Meluhlah/ESC_Board/Resources/REV01-ESC_Board_REV01 - Schematics.pdf

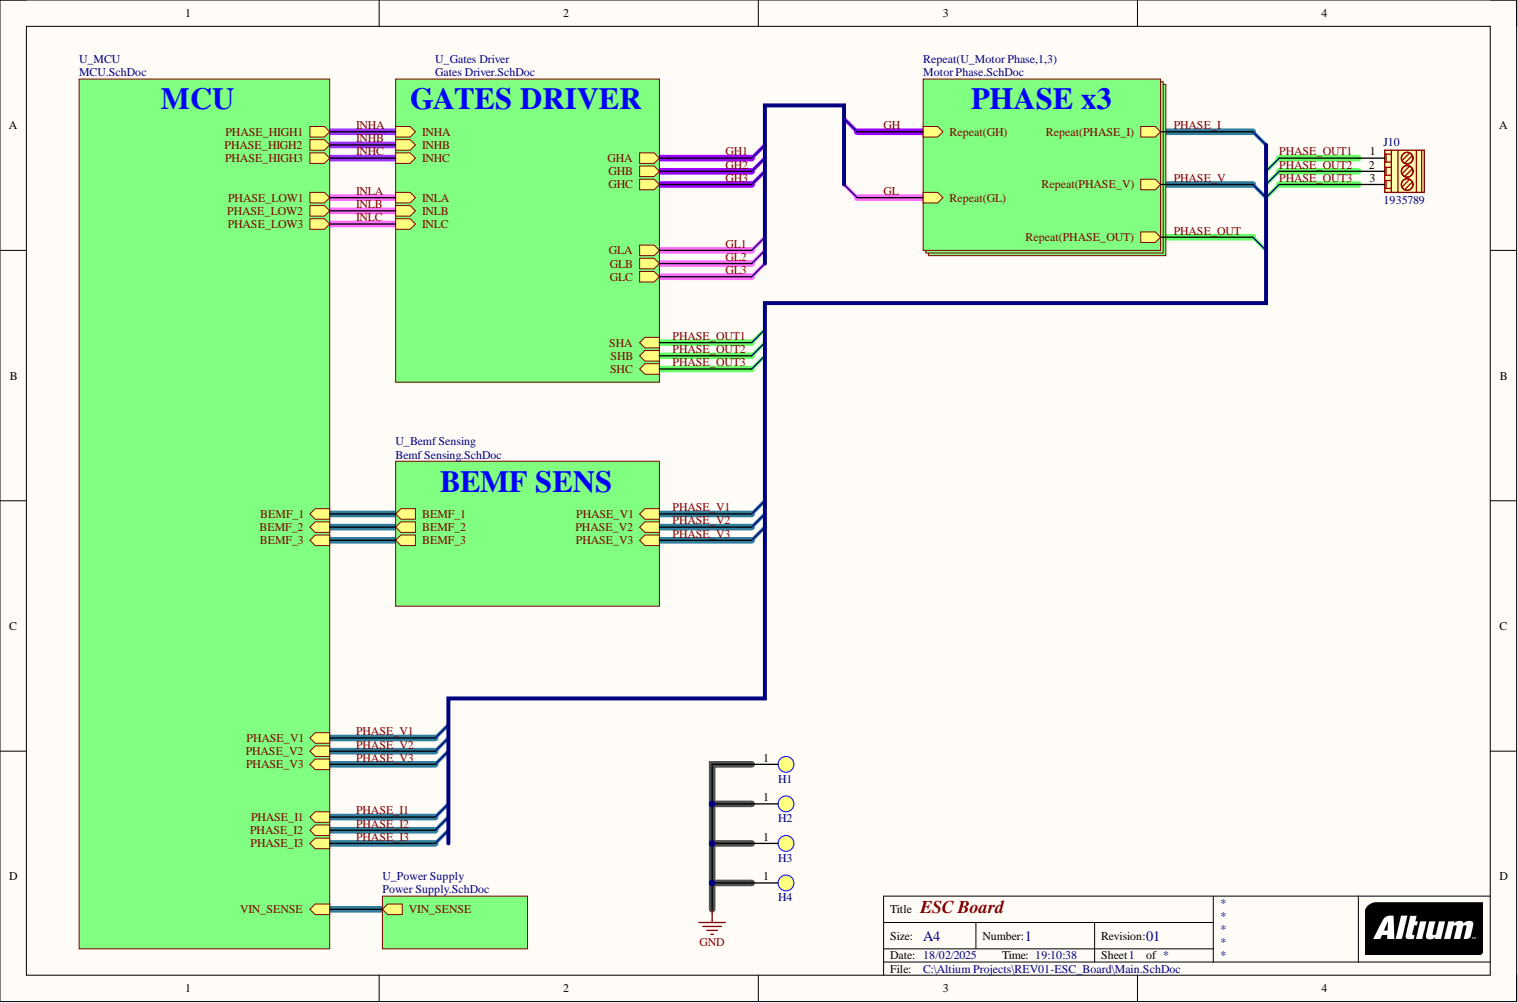
[picture p1: page 1]

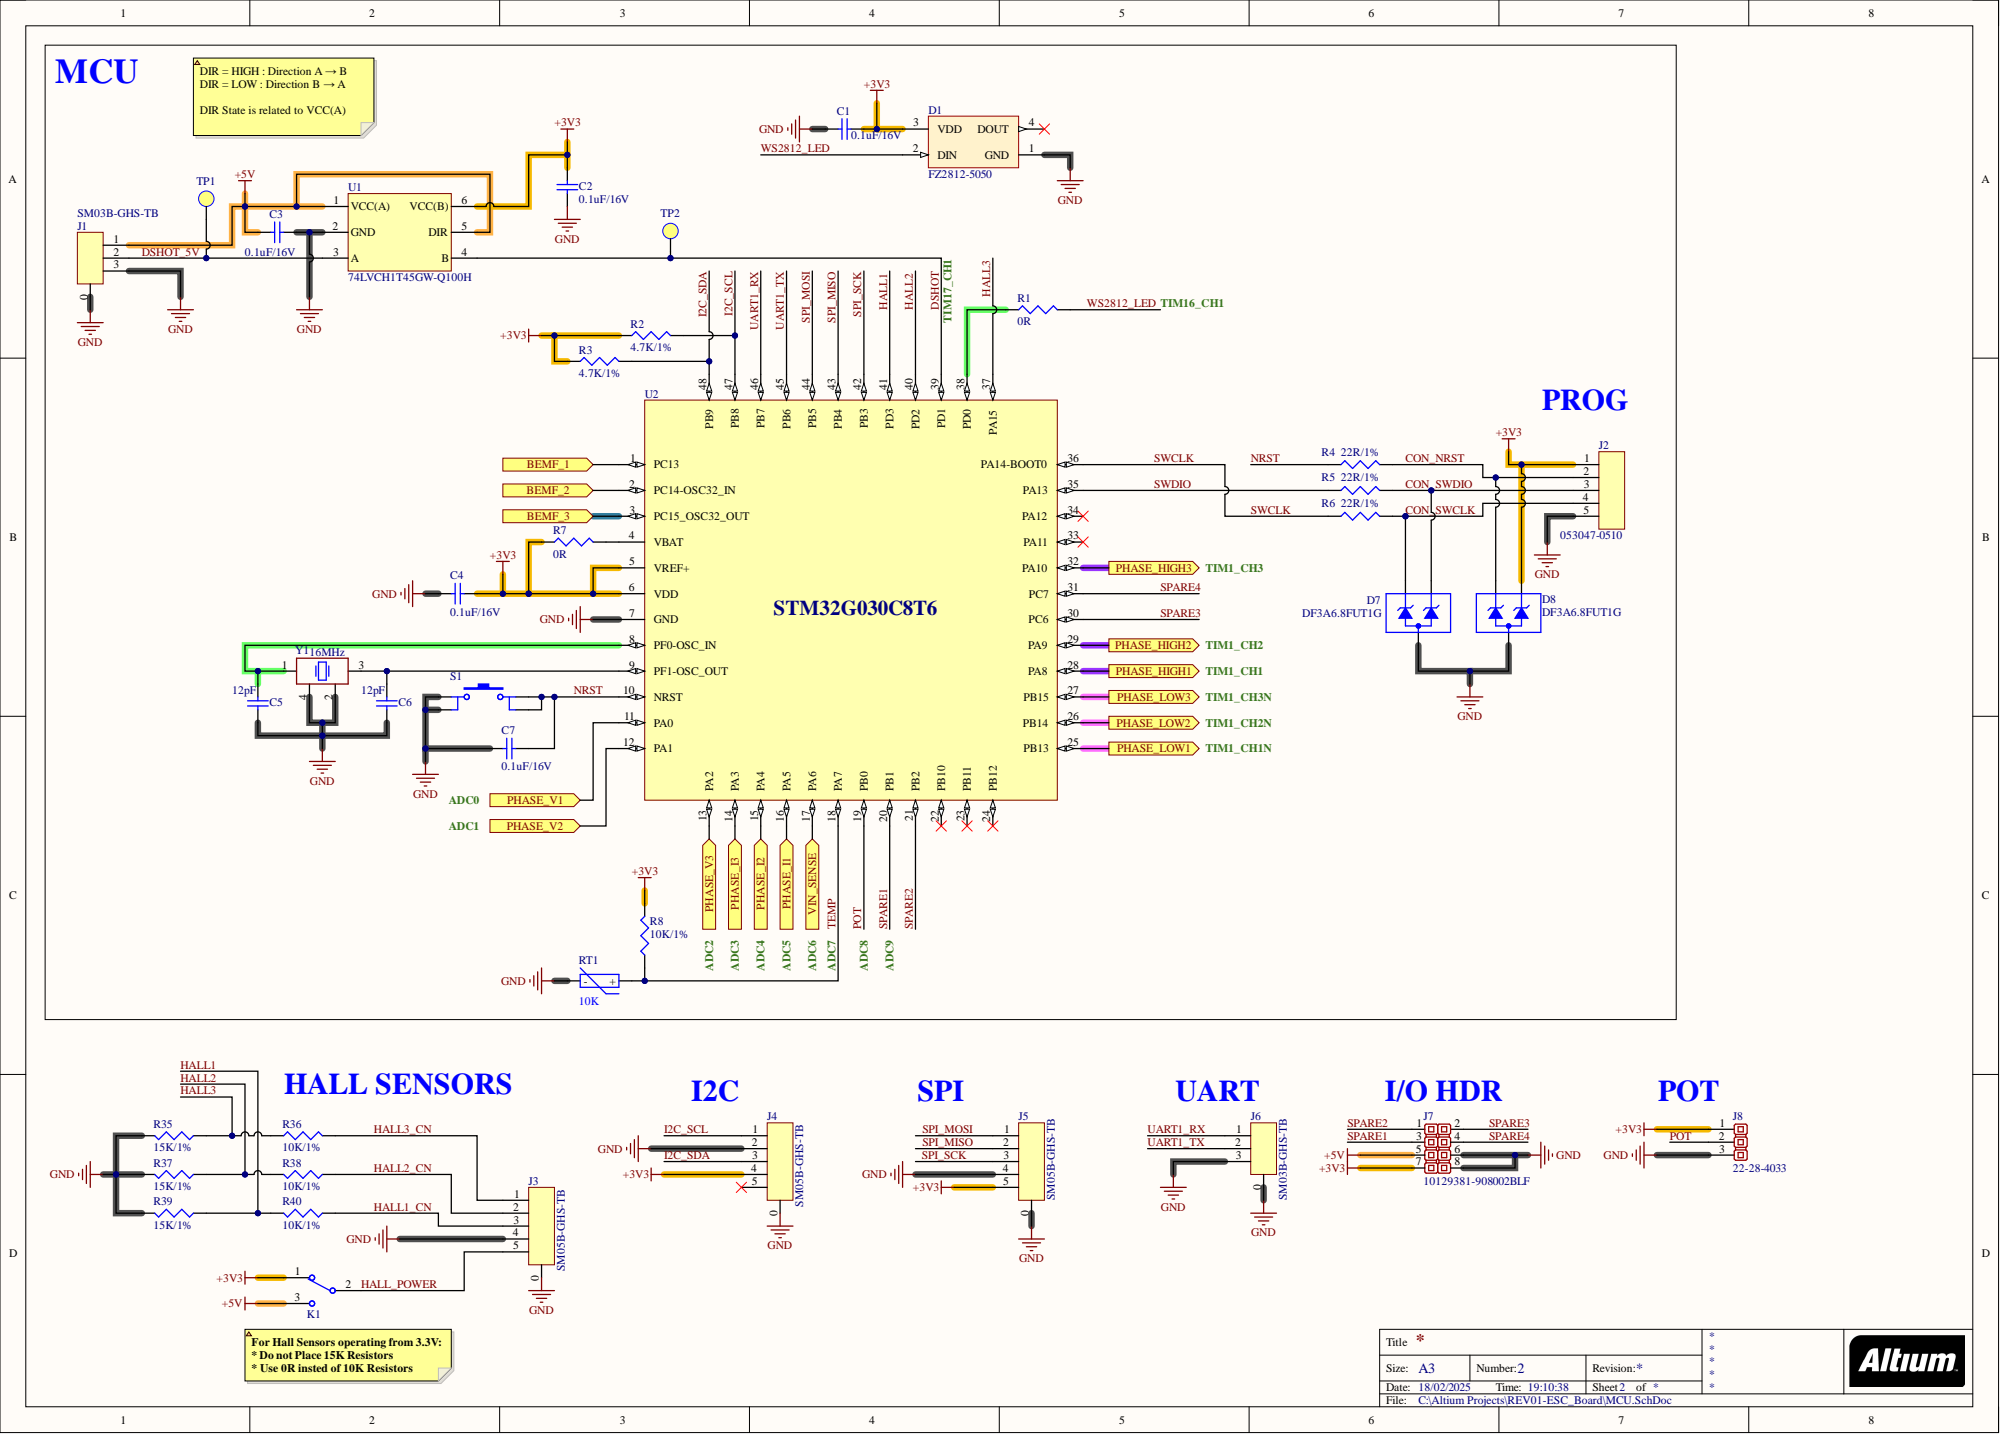
[picture p2: page 2]

DIR State is related to VCC(A)

GND 2

S1 NRST | NRST 10

HALL1_CN | 2

For Hall Sensors operating from 3.3V:
* Do not Place 15K Resistors
* Use 0R insted of 10K Resistors

C:\Altium Projects\REV01-ESC_Board\MCU.SchDoc

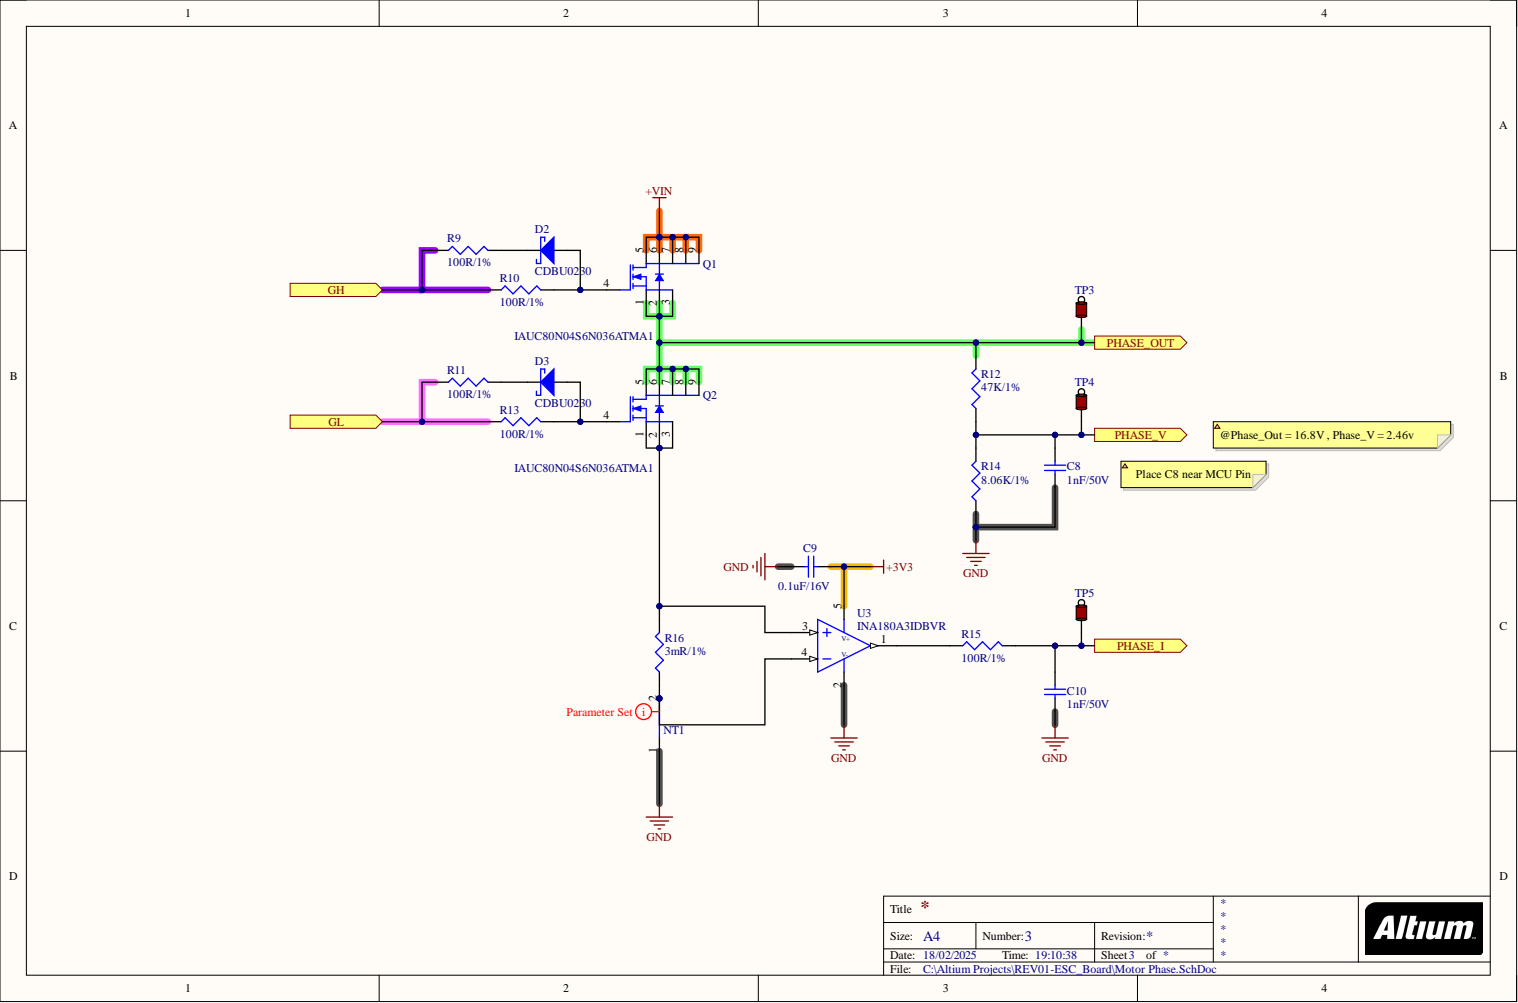
[picture p3: page 3]

Place C8 near MCU Pin

C:\Altium Projects\REV01-ESC_Board\Motor Phase.SchDoc

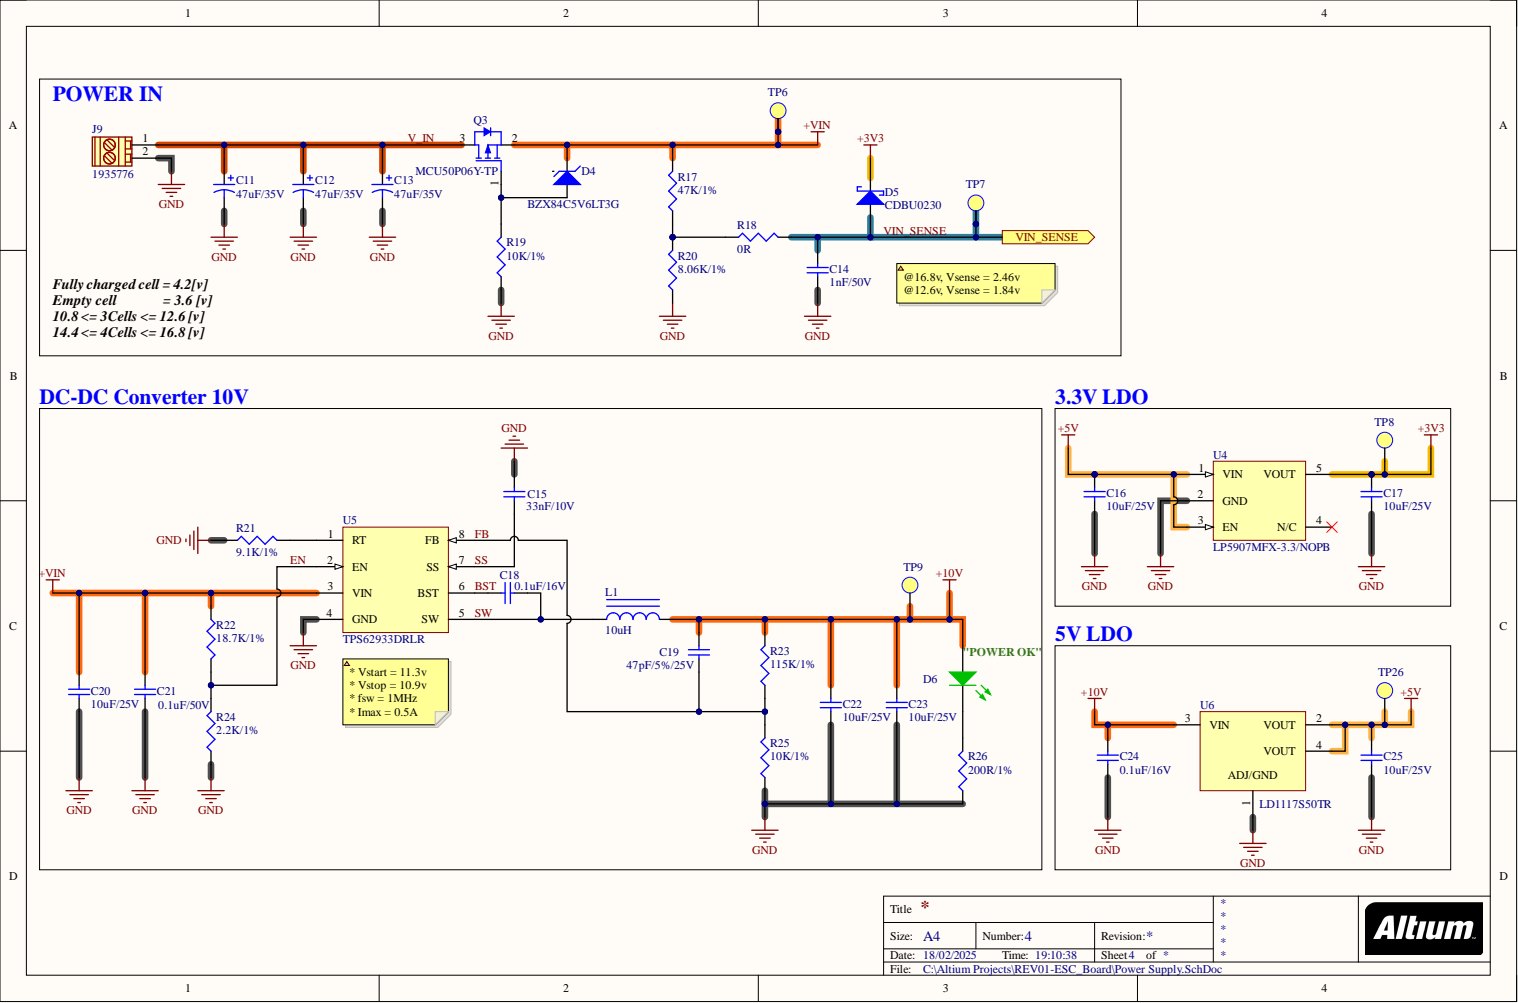
[picture p4: page 4]

C:\Altium Projects\REV01-ESC_Board\Power Supply.SchDoc

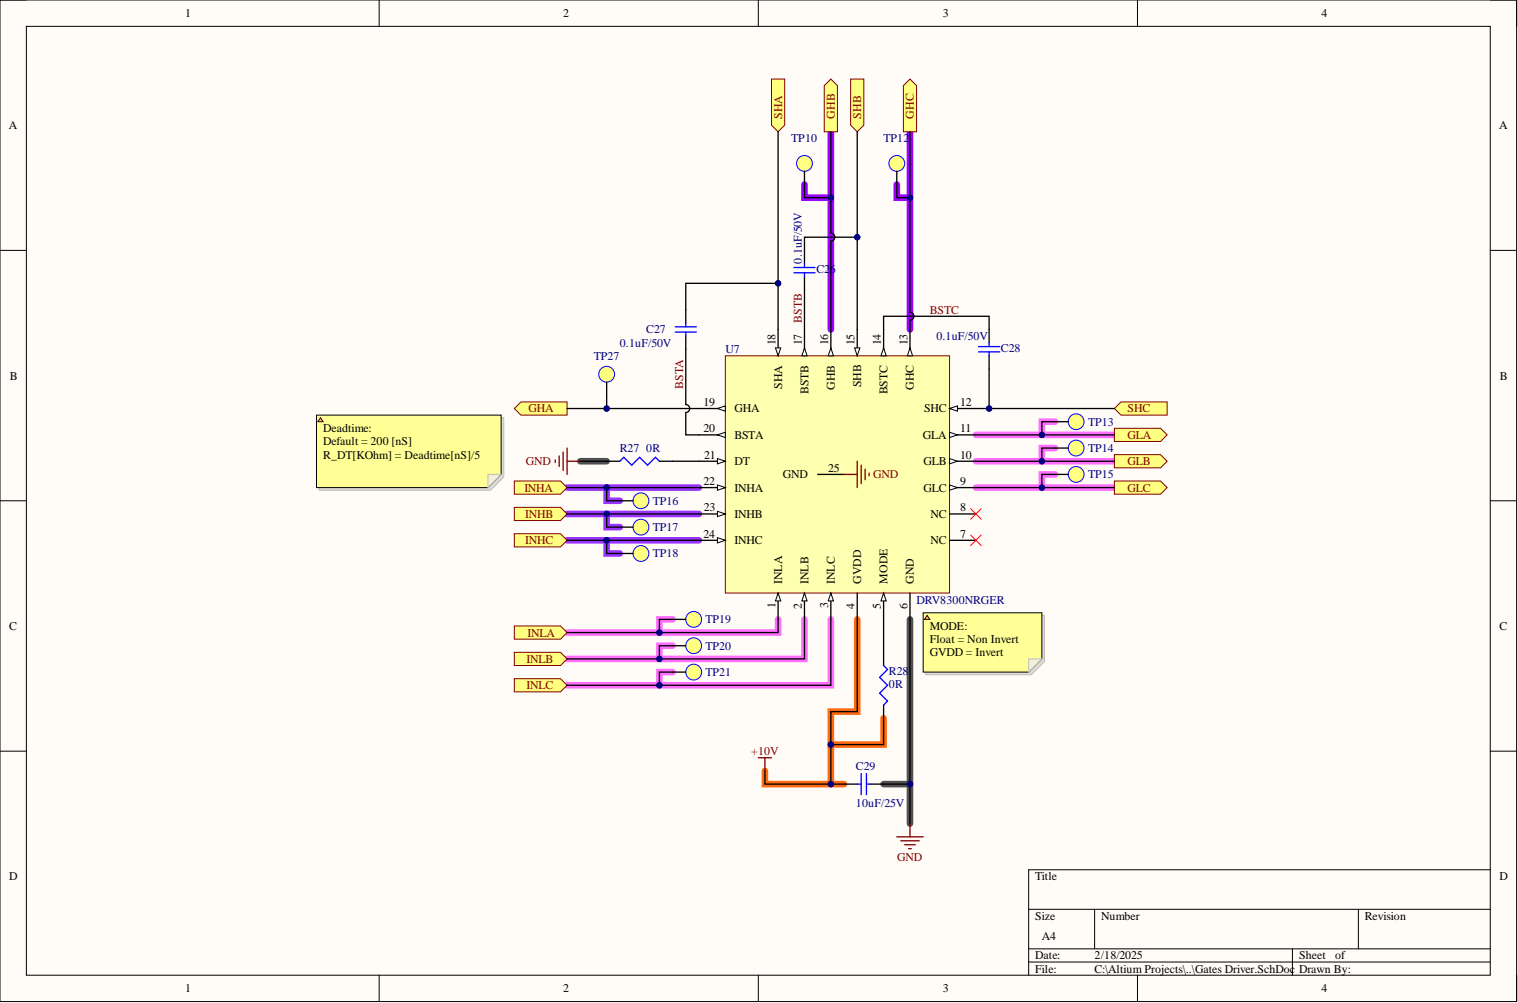
[picture p5: page 5]

INHC 24

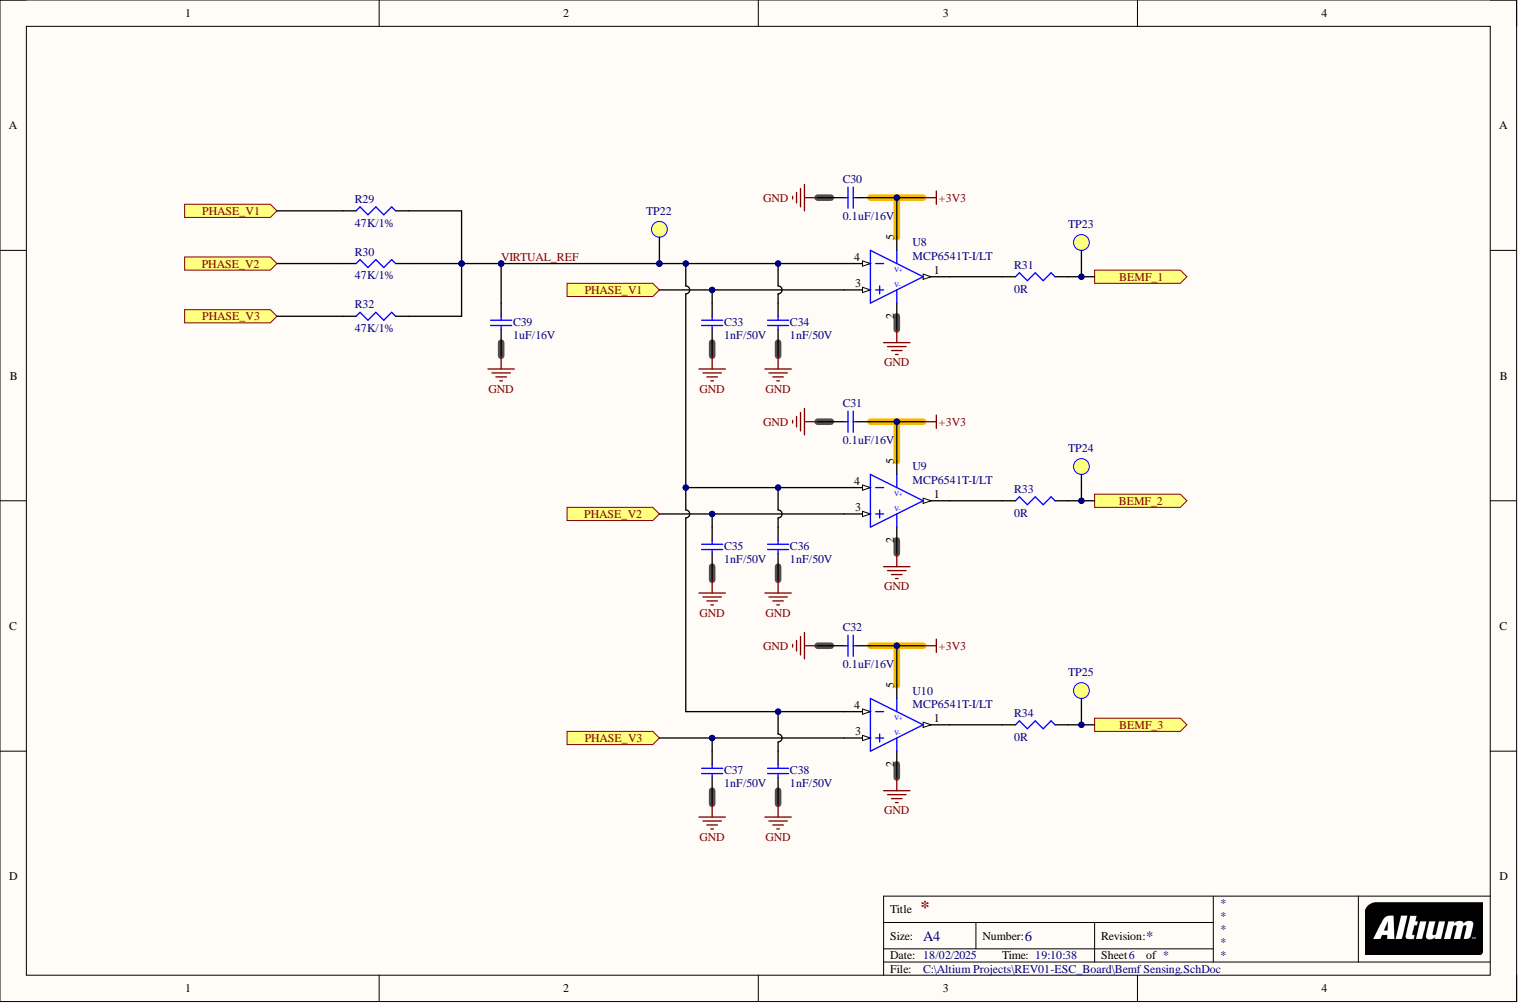
[picture p6: page 6]

C:\Altium Projects\REV01-ESC_Board\Bemf Sensing.SchDoc
