Meluhlah/ESC_Board/Cpp/Src/maincpp.cpp

#include "maincpp.h"


// ******************** Global Variables ******************** //

// Commutation Params *************************************** //

Phase phaseA(&htim1, TIM_CHANNEL_1, &TIM1->CCR1, PHASE1_LOW_GPIO_Port, PHASE1_LOW_Pin);
Phase phaseB(&htim1, TIM_CHANNEL_2, &TIM1->CCR2, PHASE2_LOW_GPIO_Port, PHASE2_LOW_Pin);
Phase phaseC(&htim1, TIM_CHANNEL_3, &TIM1->CCR3, PHASE3_LOW_GPIO_Port, PHASE3_LOW_Pin);

volatile uint8_t commutation_step;
volatile uint8_t zc_counter = 0;
volatile uint32_t imrDefaultFlags = 0;
uint8_t zcDetEnable = 0;

// ADC ****************************************************** //

volatile uint16_t adcBuffer[ADC_CHANNELS];

// Status Params ******************************************** //
volatile MotorState_e motorState;
volatile Error_e error;

// Delay Params ********************************************* //
volatile uint8_t tim14DelayFlag = 0;

// WS2812B LED Params *************************************** //
led_t ws2812b_led[NUM_OF_LEDS];

// Communication ******************************************** //
UartPacketTx_t uartPacketTx = {0x01, 0x00, 0x0000, 0x00, 0x00, DIRECTION_ABC, MOTOR_STATE_IDLE, NO_ERROR, 0x00, {0x00, 0x00, 0x00}, {0x00, 0x00, 0x00},0x00};
UartPacketRx_t uartPacketRx = {0x01, CMD_IDLE, 0x00, {0x00, 0x00, 0x00}, 0x00};
volatile uint8_t uartTxFlag = 0;
volatile uint8_t uartRxFlag = 0;
uint8_t uartRxBuffer[sizeof(UartPacketRx_t)];

// PID ****************************************************** //
PidController_t pid;
uint32_t rpmSpeed = 0;


// Debugger ************************************************* //
#ifdef DEBUGGING
Debug DEBUGGER(&huart1);
#endif

// ********************************************************** //

void phasesOff(){

    phaseA.off();
    phaseB.off();
    phaseC.off();
    zcDetEnable = 0;
    motorState = MOTOR_STATE_IDLE;

}


void setPhasesPwm(uint32_t dutyCycle){

    phaseA.set_pwm(dutyCycle);
    phaseB.set_pwm(dutyCycle);
    phaseC.set_pwm(dutyCycle);

}


void delayMicro(uint16_t delay){
	__HAL_TIM_SET_COUNTER(&DELAY_TIMER, 0);
	while(__HAL_TIM_GET_COUNTER(&DELAY_TIMER) < delay);
}


void setup()
{   
    #ifdef DEBUGGING
    HAL_Delay(2);
    ws2812b_setColor(ws2812b_led, 0, 0, 255, 0);
    DEBUGGER << "Setup Function Called.\n";
    #endif
    
    ws2812b_init(ws2812b_led);
    
    EXTI->IMR1 &= ~(BEMF_1_Pin | BEMF_2_Pin | BEMF_3_Pin);
    imrDefaultFlags = EXTI->IMR1;
    
    phasesOff();
    setPhasesPwm(0);
    commutation_step = 0;
    error = NO_ERROR;
    motorState = MOTOR_STATE_IDLE;

    HAL_UARTEx_ReceiveToIdle_DMA(&huart1, uartRxBuffer, sizeof(UartPacketRx_t));
    HAL_ADC_Start_DMA(&hadc1, (uint32_t*)adcBuffer, sizeof(adcBuffer));
    HAL_TIM_Base_Start(&htim14);
    HAL_TIM_Base_Start(&htim17);
    HAL_TIM_Base_Start_IT(&htim3);

}


void commutate()
{

    EXTI->IMR1 = imrDefaultFlags;
    EXTI->IMR1 &= ~(BEMF_1_Pin | BEMF_2_Pin | BEMF_3_Pin);

    // Disabling Interrupts on BEMF inputs
    EXTI->RTSR1 &= ~(BEMF_1_Pin | BEMF_2_Pin | BEMF_3_Pin);
    EXTI->FTSR1 &= ~(BEMF_1_Pin | BEMF_2_Pin | BEMF_3_Pin);

    // Clearing Pending Interrupt Requests
    EXTI->RPR1 |= (BEMF_1_Pin | BEMF_2_Pin | BEMF_3_Pin);
    EXTI->FPR1 |= (BEMF_1_Pin | BEMF_2_Pin | BEMF_3_Pin);

    commutation_step++;
    commutation_step %= 6;

    uint32_t timerValue = 0;

    delayMicro(2);


    /*
        STEP:   0   1   2   3   4   5 | 0   1
                                      |
        HIGH:   A   B   B   C   C   A | A   B
                                      |
        OFF:    B   A   C   B   A   C | B   A
                                      |
        LOW:    C   C   A   A   B   B | C   C
                                      |
        BEMF:   ↑   ↓   ↑   ↓   ↑   ↓ | ↑   ↓
                B   A   C   B   A   C | B   A
    */

    switch(commutation_step)
    {
        case 0:

            timerValue = __HAL_TIM_GET_COUNTER(&RPM_TIMER);
            __HAL_TIM_SET_COUNTER(&RPM_TIMER, 0);
            if(timerValue != 0){
                rpmSpeed = ((60 * 1000000) / (timerValue * MOTOR_PARAM_POLE_PAIRS));
            }
            else{
                rpmSpeed = 0;
            }

            if(1 == zcDetEnable){
                EXTI->IMR1  = (imrDefaultFlags | BEMF_2_Pin);
                EXTI->RTSR1 |= BEMF_2_Pin;  // Enabling Rising Interrupt on B
            }

            phaseB.off();    
            phaseA.high_on();
            phaseC.low_on();
        break;

        case 1:
            if(1 == zcDetEnable){
                EXTI->IMR1  = (imrDefaultFlags | BEMF_1_Pin);
                EXTI->FTSR1 |= BEMF_1_Pin; // Enabling Falling Interrupt on A
            }
            phaseA.off();    
            phaseB.high_on();
            phaseC.low_on();
        break;
        
        case 2:
            if(1 == zcDetEnable){
                EXTI->IMR1  = (imrDefaultFlags | BEMF_3_Pin);
                EXTI->RTSR1 |= BEMF_3_Pin; // Enabling Rising Interrupt on C
            }
            phaseC.off();    
            phaseB.high_on();
            phaseA.low_on();
        break;
        
        case 3:
            if(1 == zcDetEnable){
                EXTI->IMR1  = (imrDefaultFlags | BEMF_2_Pin);
                EXTI->FTSR1 |= BEMF_2_Pin; // Enabling Falling Interrupt on B
            }
            phaseB.off();    
            phaseC.high_on();
            phaseA.low_on();
        break;
        
        case 4:
            if(1 == zcDetEnable){
                EXTI->IMR1  = (imrDefaultFlags | BEMF_1_Pin);
                EXTI->RTSR1 |= BEMF_1_Pin; // Enabling Rising Interrupt on A
            }
            phaseA.off();    
            phaseC.high_on();
            phaseB.low_on();
        break;
        
        case 5:
            if(1 == zcDetEnable){
                EXTI->IMR1  = (imrDefaultFlags | BEMF_3_Pin);
                EXTI->FTSR1 |= BEMF_3_Pin; // Enabling Falling Interrupt on C
            }

            phaseC.off();    
            phaseA.high_on();
            phaseB.low_on();
        break;
        
        default:
        break;


    }

    
}

// Used to filter False readings on interrupt pin
uint8_t getBemfStateRising(){
    
    if(commutation_step == 0){
        return (HAL_GPIO_ReadPin(BEMF_2_GPIO_Port, BEMF_2_Pin));
    }

    else if(commutation_step == 2){
        return (HAL_GPIO_ReadPin(BEMF_3_GPIO_Port, BEMF_3_Pin));
    }

    else if(commutation_step == 4){
        return (HAL_GPIO_ReadPin(BEMF_1_GPIO_Port, BEMF_1_Pin));
    }

    else
        return 0;


}

// Used to filter False readings on interrupt pin
uint8_t getBemfStateFalling(){
    
    if(commutation_step == 1){
        return (HAL_GPIO_ReadPin(BEMF_1_GPIO_Port, BEMF_1_Pin));
    }

    else if(commutation_step == 3){
        return (HAL_GPIO_ReadPin(BEMF_2_GPIO_Port, BEMF_2_Pin));
    }

    else if(commutation_step == 5){
        return (HAL_GPIO_ReadPin(BEMF_3_GPIO_Port, BEMF_3_Pin));
    }
    
    else
        return 0;

}

// TODO: Maybe Remove
void HAL_UART_TxCpltCallback(UART_HandleTypeDef *huart){

    if(huart->Instance == USART1){

        #ifdef DEBUGGER
        DEBUGGER.setTxFlag();
        #endif
    }

}


void HAL_UARTEx_RxEventCallback(UART_HandleTypeDef *huart, uint16_t Size){

    if(huart->Instance == USART1){
        if(sizeof(UartPacketRx_t) == Size){
            uartRxFlag = 1;
            memcpy(&uartPacketRx, uartRxBuffer, sizeof(UartPacketRx_t));
            HAL_UARTEx_ReceiveToIdle_DMA(huart, uartRxBuffer, sizeof(UartPacketRx_t));
    }

    }

}


void HAL_TIM_PeriodElapsedCallback(TIM_HandleTypeDef *htim){

    if(htim->Instance == TIM3){
        
        makeTxPacket(&uartPacketTx);
        HAL_UART_Transmit_DMA(&huart1, (uint8_t*)&uartPacketTx, sizeof(UartPacketTx_t));

    }

}


void HAL_TIM_PWM_PulseFinishedCallback(TIM_HandleTypeDef *htim){

    // WS2812B LED
    if(htim == &TIM_HANDLE){
		HAL_TIM_PWM_Stop_DMA(&TIM_HANDLE, TIM_CHANNEL);
	}   
}


void HAL_ADC_ConvCpltCallback(ADC_HandleTypeDef *hadc){

    HAL_ADC_Start_DMA(&hadc1, (uint32_t*)adcBuffer, sizeof(adcBuffer));

}


void HAL_GPIO_EXTI_Rising_Callback(uint16_t GPIO_Pin){

    if(GPIO_Pin == BEMF_1_Pin || GPIO_Pin == BEMF_2_Pin || GPIO_Pin == BEMF_3_Pin){

        #ifdef DEBUGGING
        HAL_GPIO_TogglePin(SPARE3_GPIO_Port, SPARE3_Pin);
        #endif

        if(zcDetEnable){
            zc_counter++;
        }
        
        if(motorState == MOTOR_STATE_AUTO_COMMUTATION){  
            
            delayMicro(TEST_ZC_MEASUREMENT_DELAY);
            if(getBemfStateRising() == 0){
                return;
            }         
            commutate();     

        }
    }
    
}


void HAL_GPIO_EXTI_Falling_Callback(uint16_t GPIO_Pin){

    if(GPIO_Pin == BEMF_1_Pin || GPIO_Pin == BEMF_2_Pin || GPIO_Pin == BEMF_3_Pin){

       #ifdef DEBUGGING
       HAL_GPIO_TogglePin(SPARE3_GPIO_Port, SPARE3_Pin);
       #endif


        if(zcDetEnable){
            zc_counter++;
        }
        
        if(motorState == MOTOR_STATE_AUTO_COMMUTATION){       
        
            delayMicro(TEST_ZC_MEASUREMENT_DELAY);
            if(getBemfStateFalling() == 1){
                return;
            }         
        
            commutate();          
        }
    }
}


void calc_checkSum(UartPacketTx_t* uartPacket_tx){
    uint32_t checksum = 0;
    checksum ^= uartPacket_tx->slaveId;
    checksum ^= uartPacket_tx->dutyCycle;
    checksum ^= uartPacket_tx->rpmValue;
    checksum ^= uartPacket_tx->temp;
    checksum ^= uartPacket_tx->vin;
    checksum ^= uartPacket_tx->direction;
    checksum ^= uartPacket_tx->state;
    checksum ^= uartPacket_tx->error;
    checksum ^= uartPacket_tx->flashParameterVal;
    checksum ^= uartPacket_tx->led_rgb.red;
    checksum ^= uartPacket_tx->led_rgb.green;
    checksum ^= uartPacket_tx->led_rgb.blue;
    checksum ^= uartPacket_tx->hallSensors[0];
    checksum ^= uartPacket_tx->hallSensors[1];
    checksum ^= uartPacket_tx->hallSensors[2];

    uartPacket_tx->checksum = checksum;

}


void makeTxPacket(UartPacketTx_t* uartPacket_tx){

    uartPacket_tx->direction            = DIRECTION_ABC;                    // TODO: Add support in code
    uartPacket_tx->dutyCycle            = (uint8_t)phaseA.get_duty_cycle();
    uartPacket_tx->rpmValue             = rpmSpeed;
    uartPacket_tx->error                = error;
    uartPacket_tx->slaveId              = 0x01;                             // TODO: Add support in code
    uartPacket_tx->led_rgb.red          = ws2812b_led->red;
    uartPacket_tx->led_rgb.green        = ws2812b_led->green;
    uartPacket_tx->led_rgb.blue         = ws2812b_led->blue;
    uartPacket_tx->state                = motorState;
    uartPacket_tx->temp                 = 0x00;                             // TODO: Add support in code
    uartPacket_tx->vin                  = 0x00;                             // TODO: Add support in code
    uartPacket_tx->hallSensors[0]       = 0x00;                             // TODO: Add support in code
    uartPacket_tx->hallSensors[1]       = 0x00;                             // TODO: Add support in code
    uartPacket_tx->hallSensors[2]       = 0x00;                             // TODO: Add support in code
    uartPacket_tx->flashParameterVal    = 0x0000;                           // TODO: Add support in code
    calc_checkSum(uartPacket_tx);
    
}


void motorAlign(){

    //TODO: Make Align function Smoother, Less Amp

    #ifdef DEBUGGING
    DEBUGGER << "Motor Align Function Called.\n";
    ws2812b_setGreen(ws2812b_led, 255);
    #endif
    
    motorState = MOTOR_STATE_ALIGN;
    setPhasesPwm(ALIGN_PWM_INIT);
    phaseB.low_on();
    phaseC.low_on();
    phaseA.high_on();

    float currentPwm = ALIGN_PWM_INIT;

    for(int i = 0; i < ALIGN_STEPS_NUM; i++){
        currentPwm += ALIGN_PWM_INCREMENT_PER_STEP;

        if(currentPwm <= ALIGN_PWM_TARGET){
            phaseA.set_pwm((uint32_t)currentPwm);
        }        

        HAL_Delay(ALIGN_STEP_DURATION_MS);
    }

    commutation_step = 0;

    #ifdef DEBUGGING
    DEBUGGER << "Motor Align Function Done.\n";
    #endif
}


void motorRamp(){

    #ifdef DEBUGGING
    DEBUGGER << "Motor Ramp Function Called.\n";
    ws2812b_setBlue(ws2812b_led, 255);
    #endif
    
    zcDetEnable = 0;
    zc_counter = 0;
    motorState = MOTOR_STATE_RAMP;
    setPhasesPwm(ALIGN_PWM_TARGET);
    uint16_t stepDelayUs = RAMP_STEP_INIT_DURATION_US;

    for(int i = 0; i < RAMP_STEPS_NUM; i++){

        if(zc_counter >= RAMP_ZC_DETECTION_THRESHOLD){

            motorState = MOTOR_STATE_AUTO_COMMUTATION;
            break;

        }

        if(i == RAMP_ZC_DET_ENABLE_STEP){

            zcDetEnable = 1;

        }
        commutate();

        if(stepDelayUs - RAMP_STEP_DECREMENT_PER_STEP_US >= RAMP_STEP_TARGET_DURATION_US){
           stepDelayUs -= RAMP_STEP_DECREMENT_PER_STEP_US;
        }
        delayMicro(stepDelayUs);
    }
    
    // Check for motor Lock.
    if(motorState != MOTOR_STATE_AUTO_COMMUTATION){
        error = ERROR_MOTOR_LOCKED;
        phasesOff();

    }

    #ifdef DEBUGGING
    DEBUGGER << "Motor Ramp Function Done.\n";
    #endif

}


void execGuiCommands(){

    switch(uartPacketRx.command){
        case CMD_MOTOR_STOP:
            phasesOff();
            break;

        case CMD_MOTOR_START:
            motorAlign();
            motorRamp();
            break;

        case CMD_MOTOR_ALIGN:
            motorAlign();
            phasesOff();
            break;

        case CMD_LED_SET_RED:
            ws2812b_setRed(ws2812b_led, uartPacketRx.data[0]);
            break;

        case CMD_LED_SET_GREEN:
            ws2812b_setGreen(ws2812b_led, uartPacketRx.data[0]);
            break;

        case CMD_LED_SET_BLUE:
            ws2812b_setBlue(ws2812b_led, uartPacketRx.data[0]);
            break;

        case CMD_LED_SET_RGB:
            ws2812b_setColor(ws2812b_led, uartPacketRx.data[0], uartPacketRx.data[1], uartPacketRx.data[2], 0);
            break;

        case CMD_MOTOR_SET_SPEED:
            if(uartPacketRx.data[0] <= MOTOR_MAX_PWM){

               setPhasesPwm((uint32_t)uartPacketRx.data[0]);

            }
            break;

        default:
            break;
    }

}


void maincpp(){

    setup();

    while(1){

        if(1 == uartRxFlag){
            uartRxFlag = 0;
            execGuiCommands();
        }

    }
    // test
}
