Meluhlah/ESC_Board/ESC_Board.ioc

Mcu.UserName=STM32G030C8Tx
PA0.GPIO_Label=PHASE_V1
PA0.Signal=ADC1_IN0
PA1.GPIO_Label=PHASE_I1
PA1.Signal=ADC1_IN1
PA10.GPIO_Label=PHASE3_HIGH
PA10.Signal=S_TIM1_CH3
PA13.Signal=SYS_SWDIO
PA14-BOOT0.Signal=SYS_SWCLK
PA2.GPIO_Label=PHASE_V2
PA2.Signal=ADC1_IN2
PA3.GPIO_Label=PHASE_I2
PA3.Signal=ADC1_IN3
PA4.GPIO_Label=PHASE_V3
PA4.Signal=ADC1_IN4
PA5.GPIO_Label=PHASE_I3
PA5.Signal=ADC1_IN5
PA6.GPIO_Label=VIN
PA6.Signal=ADC1_IN6
PA7.GPIO_Label=TEMP
PA7.Signal=ADC1_IN7
PA8.GPIO_Label=PHASE1_HIGH
PA8.Signal=S_TIM1_CH1
PA9.GPIO_Label=PHASE2_HIGH
PA9.Signal=S_TIM1_CH2
PB0.GPIO_Label=POTEMTIOMETER
PB0.Signal=ADC1_IN8
PB1.GPIO_Label=SPARE1
PB1.Signal=ADC1_IN9
PB13.GPIO_Label=PHASE1_LOW
PB13.Signal=GPIO_Output
PB14.GPIO_Label=PHASE2_LOW
PB14.Signal=GPIO_Output
PB15.GPIO_Label=PHASE3_LOW
PB15.Signal=GPIO_Output
PB2.GPIO_Label=SPARE2
PB2.Signal=ADC1_IN10
PB3.Signal=SPI1_SCK
PB4.Signal=SPI1_MISO
PB5.Signal=SPI1_MOSI
PB6.Signal=USART1_TX
PB7.Signal=USART1_RX
PB8.Signal=I2C1_SCL
PB9.Signal=I2C1_SDA
PC13.GPIO_Label=BEMF_1
PC13.Signal=GPXTI13
PC6.GPIO_Label=SPARE3
PC6.Signal=GPIO_Output
PC7.GPIO_Label=SPARE4
PC7.Signal=GPIO_Output
PD0.GPIO_Label=WS2812_LED
PD0.Signal=S_TIM16_CH1
PD1.GPIO_Label=DSHOT
PD1.Signal=S_TIM17_CH1
PD2.GPIO_Label=HALL2
PD2.Signal=GPXTI2
PD3.GPIO_Label=HALL1
PD3.Signal=GPXTI3
