Meluhlah/ESC_Board/Core/Inc/main.h

#define BEMF_1_Pin GPIO_PIN_13
#define BEMF_1_GPIO_Port GPIOC
#define BEMF_1_EXTI_IRQn EXTI4_15_IRQn
#define BEMF_2_Pin GPIO_PIN_14
#define BEMF_2_GPIO_Port GPIOC
#define BEMF_2_EXTI_IRQn EXTI4_15_IRQn
#define BEMF_3_Pin GPIO_PIN_15
#define BEMF_3_GPIO_Port GPIOC
#define BEMF_3_EXTI_IRQn EXTI4_15_IRQn
#define PHASE_V1_Pin GPIO_PIN_0
#define PHASE_V1_GPIO_Port GPIOA
#define PHASE_I1_Pin GPIO_PIN_1
#define PHASE_I1_GPIO_Port GPIOA
#define PHASE_V2_Pin GPIO_PIN_2
#define PHASE_V2_GPIO_Port GPIOA
#define PHASE_I2_Pin GPIO_PIN_3
#define PHASE_I2_GPIO_Port GPIOA
#define PHASE_V3_Pin GPIO_PIN_4
#define PHASE_V3_GPIO_Port GPIOA
#define PHASE_I3_Pin GPIO_PIN_5
#define PHASE_I3_GPIO_Port GPIOA
#define VIN_Pin GPIO_PIN_6
#define VIN_GPIO_Port GPIOA
#define TEMP_Pin GPIO_PIN_7
#define TEMP_GPIO_Port GPIOA
#define POTEMTIOMETER_Pin GPIO_PIN_0
#define POTEMTIOMETER_GPIO_Port GPIOB
#define SPARE1_Pin GPIO_PIN_1
#define SPARE1_GPIO_Port GPIOB
#define SPARE2_Pin GPIO_PIN_2
#define SPARE2_GPIO_Port GPIOB
#define PHASE1_LOW_Pin GPIO_PIN_13
#define PHASE1_LOW_GPIO_Port GPIOB
#define PHASE2_LOW_Pin GPIO_PIN_14
#define PHASE2_LOW_GPIO_Port GPIOB
#define PHASE3_LOW_Pin GPIO_PIN_15
#define PHASE3_LOW_GPIO_Port GPIOB
#define PHASE1_HIGH_Pin GPIO_PIN_8
#define PHASE1_HIGH_GPIO_Port GPIOA
#define PHASE2_HIGH_Pin GPIO_PIN_9
#define PHASE2_HIGH_GPIO_Port GPIOA
#define SPARE3_Pin GPIO_PIN_6
#define SPARE3_GPIO_Port GPIOC
#define SPARE4_Pin GPIO_PIN_7
#define SPARE4_GPIO_Port GPIOC
#define PHASE3_HIGH_Pin GPIO_PIN_10
#define PHASE3_HIGH_GPIO_Port GPIOA
#define WS2812_LED_Pin GPIO_PIN_0
#define WS2812_LED_GPIO_Port GPIOD
#define DSHOT_Pin GPIO_PIN_1
#define DSHOT_GPIO_Port GPIOD
#define HALL2_Pin GPIO_PIN_2
#define HALL2_GPIO_Port GPIOD
#define HALL1_Pin GPIO_PIN_3
#define HALL1_GPIO_Port GPIOD
