Meluhlah/ESC_Board/Cpp/Inc/maincpp.h

#ifndef _MAINCPP_H_
#define _MAINCPP_H_

#include "main.h"
#include "Phase.h"
#include "Debug.h"
#include "defines.h"
#include "ws2812b.h"
#include "pid.h"

void setup();
void commutate();
void delayMicro(uint16_t delay);
uint8_t getBemfStateRising();
uint8_t getBemfStateFalling();
void motorAlign();
void motorRamp();
void phasesOff();
void setPhasesPwm(uint32_t dutyCycle);
void execGuiCommands();
void makeTxPacket(UartPacketTx_t* uartPacket_tx);
void calc_checkSum(UartPacketTx_t* uartPacket_tx);

extern "C"{

extern TIM_HandleTypeDef htim1;
extern TIM_HandleTypeDef htim16;
extern TIM_HandleTypeDef htim14;
extern TIM_HandleTypeDef htim17;
extern UART_HandleTypeDef huart1;
extern ADC_HandleTypeDef hadc1;

}

#endif // _MAINCPP_H_
