Meluhlah/ESC_Board/(commit log)

2025-03-19 Added infrastructure uart communication with gui
2025-03-20 Changed uart functions to take an argument of UartPacketTx_t
2025-03-22 ADC Enabled
2025-04-19 Added RPM Calculation and PID Struct
